oobayly/MooringLights/NE555 Pulse Frequency Controller.jpg

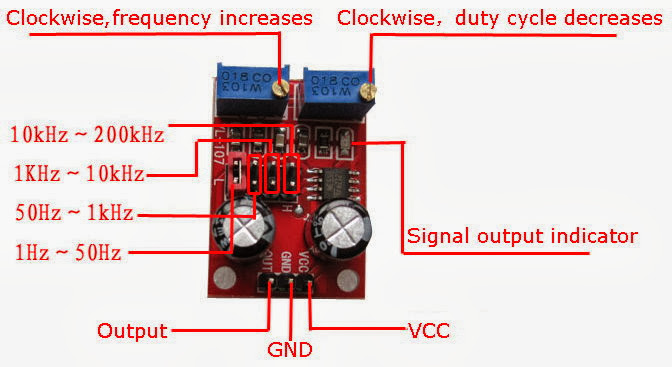
NE555 Pulse Frequency Controller.jpg
