oobayly/MooringLights/eagle/Controller.pdf

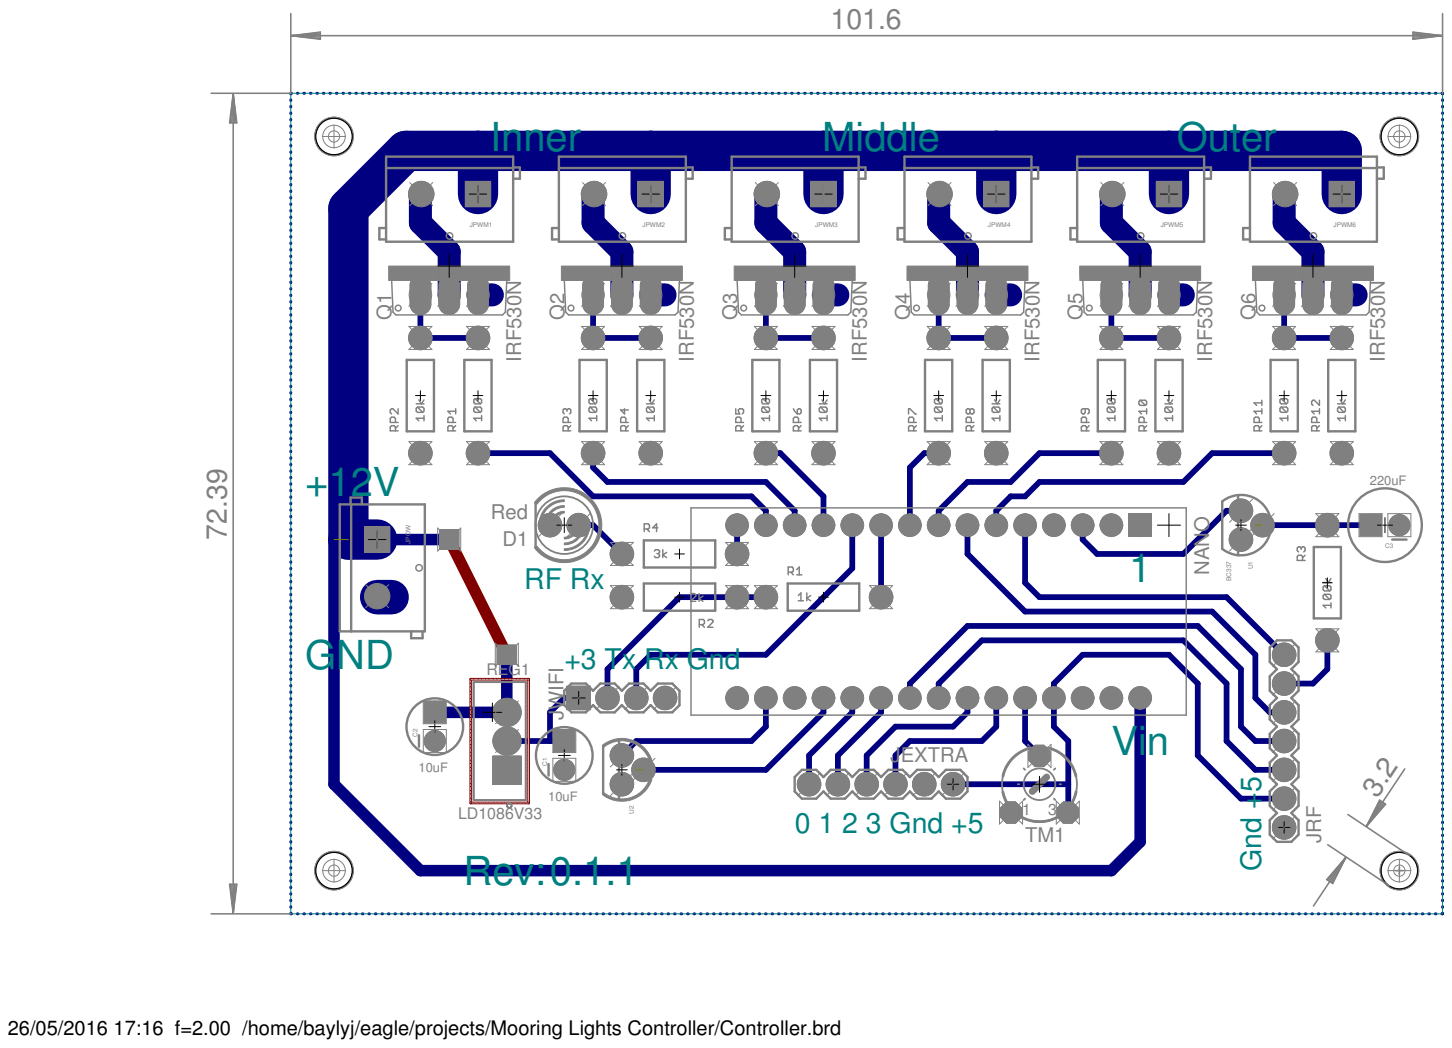
[picture p3: page 1]

26/05/2016 17:16 f=2.00 /home/baylyj/eagle/projects/Mooring Lights Controller/Controller.brd
