oobayly/MooringLights/eagle/Controller.brd

## EAGLE design eagle/Controller.brd (2016-05-26)

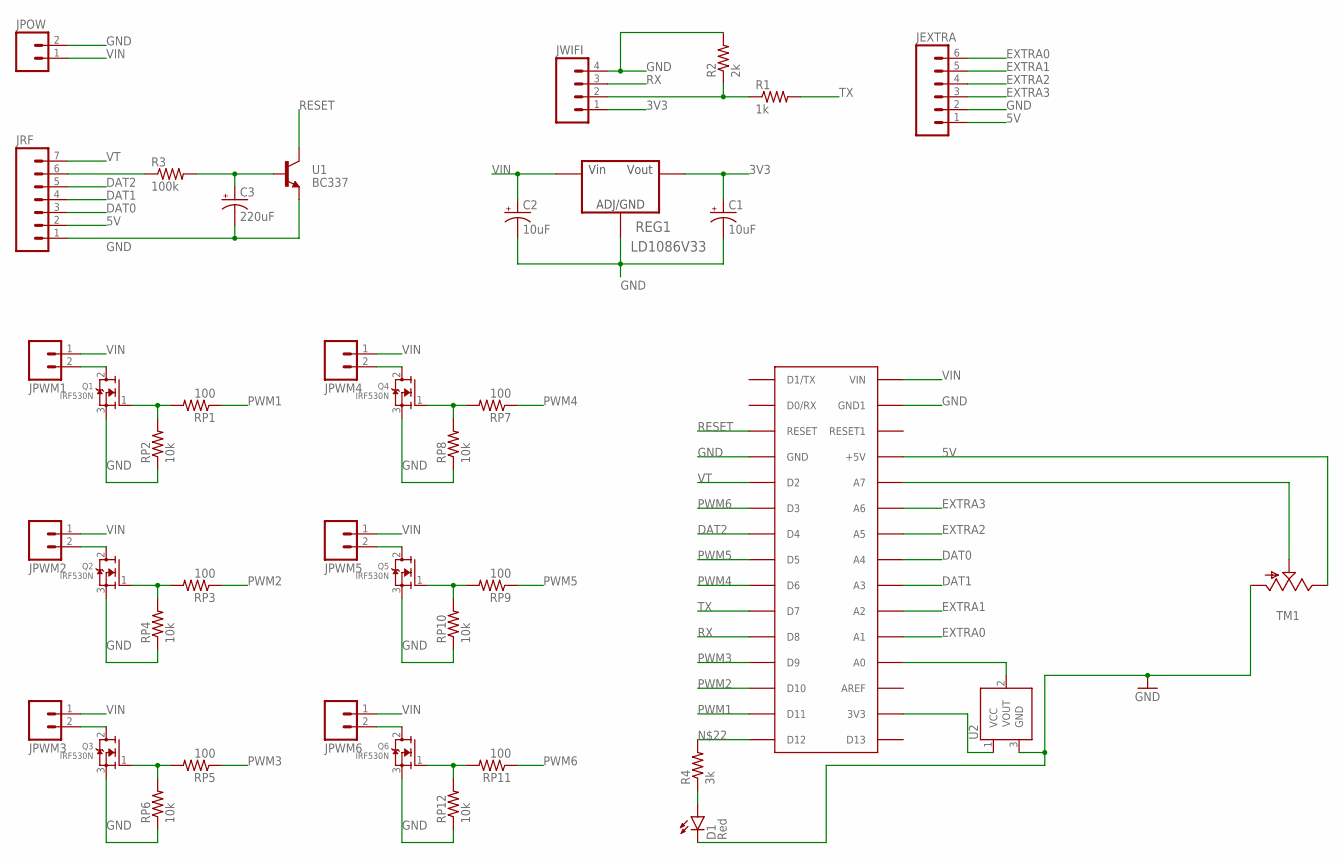
[picture p4: schematic Controller.sch]

Parts:
C1, C2: 10uF; CPOL-RADIAL-10UF-25V
C3: 220uF; CPOL-RADIAL-100UF-25V
D1: Red; LED5MM
JEXTRA: M06SILK_FEMALE_PTH; 1X06
JPOW: M025MM; SCREWTERMINAL-5MM-2
JPWM1, JPWM2, JPWM3, JPWM4, JPWM5, JPWM6: M025MM; SCREWTERMINAL-5MM-2
JRF: M07; 1X07
JWIFI: M04PTH; 1X04
NANO: ARDUINONANONO-MOUNT; PDIP-32-NO-MOUNT
Q1, Q2, Q3, Q4, Q5, Q6: IRF530N; TO220V
R1: 1k; AXIAL-0.4
R2: 2k; AXIAL-0.4
R3: 100k; AXIAL-0.4
R4: 3k; AXIAL-0.4
REG1: LD1086V33; TO254P482X1024X3124-3P
RP1, RP3, RP5, RP7, RP9, RP11: 100; AXIAL-0.4
RP2, RP4, RP6, RP8, RP10, RP12: 10k; AXIAL-0.4
TM1: TRIM; 6MM
U1: BC337; TO-92
U2: TMP36GT9; TO-92

Connections:
3V3: C1.1 (+), JWIFI.1, REG1.2 (VOUT)
5V: JEXTRA.1, JRF.2, NANO.+5V, TM1.E
DAT0: JRF.3, NANO.A3 (A4)
DAT1: JRF.4, NANO.A4 (A3)
DAT2: JRF.5, NANO.D4
EXTRA0: JEXTRA.6, NANO.A6 (A1)
EXTRA1: JEXTRA.5, NANO.A5 (A2)
EXTRA2: JEXTRA.4, NANO.A2 (A5)
EXTRA3: JEXTRA.3, NANO.A1 (A6)
GND: C1.2 (-), C2.2 (-), C3.2 (-), D1.K (C), JEXTRA.2, JPOW.2, JRF.1, JWIFI.4, NANO.GND, NANO.GND1, Q1.3 (S), Q2.3 (S), Q3.3 (S), Q4.3 (S), Q5.3 (S), Q6.3 (S), R2.P$2 (2), REG1.1 (ADJ/GND), RP2.P$1 (1), RP4.P$1 (1), RP6.P$1 (1), RP8.P$1 (1), RP10.P$1 (1), RP12.P$1 (1), TM1.A, U1.3 (E), U2.3 (GND)
unnamed: NANO.A0 (A7), TM1.S
unnamed: JWIFI.2, R1.P$1 (1), R2.P$1 (1)
unnamed: JRF.6, R3.P$1 (1)
unnamed: C3.1 (+), R3.P$2 (2), U1.2 (B)
unnamed: Q1.1 (G), RP1.P$2 (2), RP2.P$2 (2)
unnamed: JPWM1.2, Q1.2 (D)
unnamed: Q2.1 (G), RP3.P$2 (2), RP4.P$2 (2)
unnamed: D1.A, R4.P$1 (1)
unnamed: Q3.1 (G), RP5.P$2 (2), RP6.P$2 (2)
unnamed: JPWM3.2, Q3.2 (D)
unnamed: Q4.1 (G), RP7.P$2 (2), RP8.P$2 (2)
unnamed: JPWM4.2, Q4.2 (D)
unnamed: Q5.1 (G), RP9.P$2 (2), RP10.P$2 (2)
unnamed: JPWM5.2, Q5.2 (D)
unnamed: Q6.1 (G), RP11.P$2 (2), RP12.P$2 (2)
unnamed: JPWM6.2, Q6.2 (D)
unnamed: JPWM2.2, Q2.2 (D)
unnamed: NANO.A7 (A0), U2.2 (VOUT)
unnamed: NANO.D12, R4.P$2 (2)
unnamed: NANO.3V3, U2.1 (VCC)
PWM1: NANO.D11, RP1.P$1 (1)
PWM2: NANO.D10, RP3.P$1 (1)
PWM3: NANO.D9, RP5.P$1 (1)
PWM4: NANO.D6, RP7.P$1 (1)
PWM5: NANO.D5, RP9.P$1 (1)
PWM6: NANO.D3, RP11.P$1 (1)
RESET: NANO.RESET, U1.1 (C)
RX: JWIFI.3, NANO.D8
TX: NANO.D7, R1.P$2 (2)
VIN: C2.1 (+), JPOW.1, JPWM1.1, JPWM2.1, JPWM3.1, JPWM4.1, JPWM5.1, JPWM6.1, NANO.VIN, REG1.3 (VIN)
VT: JRF.7, NANO.D2

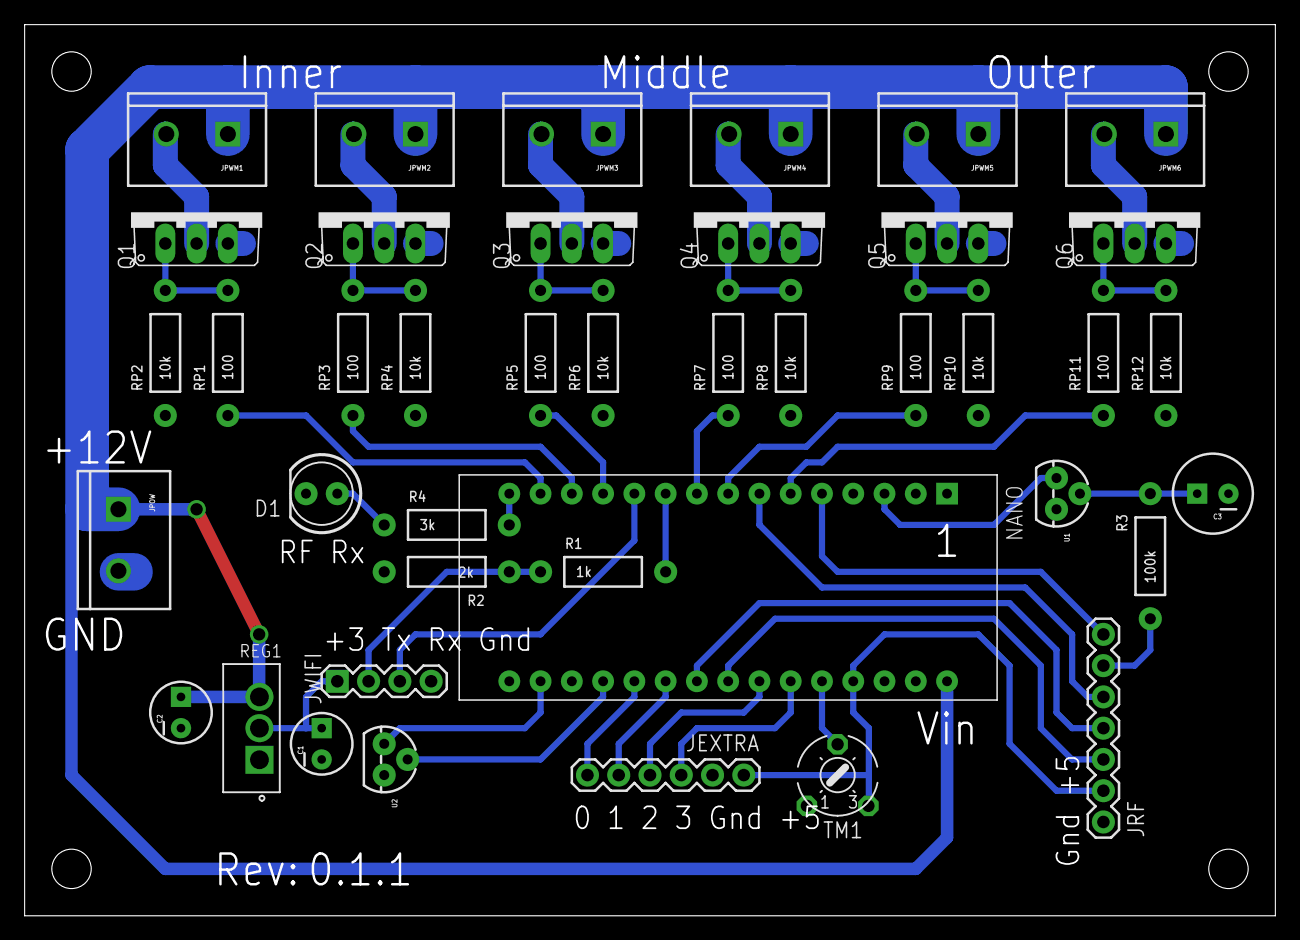
[picture p5: board Controller.brd from above]

Board: 2 copper layers, 101.6 x 72.4 mm, 41 parts (0 on the bottom side), 41 nets.
