oobayly/MooringLights/(commit log)

2015-11-12 Add instructions for hardware PWM controller
2015-11-13 Move socket into its own factory
2015-11-13 Improve logging for unexpected packets and return the LED status on SET
2015-11-13 Make the case the same in TCPClient
2015-11-13 Use left-hand close button
2015-11-17 Hacky workaround - restart the TCP server every 5 minutes
    [controller.h, controller.ino]
2015-11-17 Attempt to reconnect to the Wifi every minute if there is an error
    [controller.h, controller.ino]
2015-11-17 Use getMUX to test if the board has been reset
    [controller.h, controller.ino]
2015-11-17 Move reset wifi to main loop
    [controller.ino]
2016-05-18 Add Eagle CAD project
    [Controller.brd, Controller.sch]
2016-05-18 Fix incorrect PWM initialisation and Timer1 duty cycle shift
    [pwm.cpp]
2016-05-18 Revert to 1ms timer for pwm frequency and only trigger every TIMER1_INTERVAL
    [controller.ino, core.h]
2016-05-19 Update board
    Remove 2 trim pots and replace with EXTRA2/3
    Increase size of vias
    Increase border of board
    Improve labeling
    [Controller.brd, Controller.sch]
2016-05-20 Updated BOM
2016-05-20 Add Revision to board
    [Controller.brd]
2016-05-23 Add more text labels
    [Controller.brd]
2016-05-23 Add default defines in case passwords.h is not present
2016-05-23 Get rid of the radio button list due to delay bug in chrome
    See https://forum.ionicframework.com/t/bug-unwanted-delay-in-updating-ng-repeat-a-populated-with-ion-radio/2275/3
2016-05-23 Move options to popover and add temperature information
2016-05-25 Fix: Copy the actual size of the Chaser struct when READing
    [wifi.cpp]
2016-05-26 Decrease timer tick resolution
    Seems to interfere with Software Serial
    [core.h]
2016-05-26 Fix warnings and wrap string in F macro
    [controller.ino, core.h]
2016-05-26 Change reset circuit to work with lower Arduino resistor values
    [Controller.brd, Controller.sch]
2016-05-27 Add poup for writing custom chaser to preset button
2016-05-27 Move temperature fucntion to LightService
2016-06-03 Decrease number of scenes per chaser due to buffer constraints
    Still need to increase the buffer in SoftwareSerial.h:
    http://forum.arduino.cc/index.php?topic=244398.0
2016-06-03 Reduce programs again due to buffer contraints
    Didn't take command into account
    [core.h]
